1847123212/Zynq7010_eink_controller/controller/Eink_controller_V1.0/Eink_controller_V1.0.ip_user_files/sim_scripts/FRAME_LOGIC/activehdl/file_info.txt

axi4stream_vip_axi4streampc.sv,systemverilog,xilinx_vip,../../../../../../../../../Xilinx/Vivado/2020.2/data/xilinx_vip/hdl/axi4stream_vip_axi4streampc.sv,incdir="../../../../Eink_controller.gen/sources_1/ip/FRAME_LOGIC/hdl/verilog"
axi_vip_axi4pc.sv,systemverilog,xilinx_vip,../../../../../../../../../Xilinx/Vivado/2020.2/data/xilinx_vip/hdl/axi_vip_axi4pc.sv,incdir="../../../../Eink_controller.gen/sources_1/ip/FRAME_LOGIC/hdl/verilog"
xil_common_vip_pkg.sv,systemverilog,xilinx_vip,../../../../../../../../../Xilinx/Vivado/2020.2/data/xilinx_vip/hdl/xil_common_vip_pkg.sv,incdir="../../../../Eink_controller.gen/sources_1/ip/FRAME_LOGIC/hdl/verilog"
axi4stream_vip_pkg.sv,systemverilog,xilinx_vip,../../../../../../../../../Xilinx/Vivado/2020.2/data/xilinx_vip/hdl/axi4stream_vip_pkg.sv,incdir="../../../../Eink_controller.gen/sources_1/ip/FRAME_LOGIC/hdl/verilog"
axi_vip_pkg.sv,systemverilog,xilinx_vip,../../../../../../../../../Xilinx/Vivado/2020.2/data/xilinx_vip/hdl/axi_vip_pkg.sv,incdir="../../../../Eink_controller.gen/sources_1/ip/FRAME_LOGIC/hdl/verilog"
axi4stream_vip_if.sv,systemverilog,xilinx_vip,../../../../../../../../../Xilinx/Vivado/2020.2/data/xilinx_vip/hdl/axi4stream_vip_if.sv,incdir="../../../../Eink_controller.gen/sources_1/ip/FRAME_LOGIC/hdl/verilog"
axi_vip_if.sv,systemverilog,xilinx_vip,../../../../../../../../../Xilinx/Vivado/2020.2/data/xilinx_vip/hdl/axi_vip_if.sv,incdir="../../../../Eink_controller.gen/sources_1/ip/FRAME_LOGIC/hdl/verilog"
clk_vip_if.sv,systemverilog,xilinx_vip,../../../../../../../../../Xilinx/Vivado/2020.2/data/xilinx_vip/hdl/clk_vip_if.sv,incdir="../../../../Eink_controller.gen/sources_1/ip/FRAME_LOGIC/hdl/verilog"
rst_vip_if.sv,systemverilog,xilinx_vip,../../../../../../../../../Xilinx/Vivado/2020.2/data/xilinx_vip/hdl/rst_vip_if.sv,incdir="../../../../Eink_controller.gen/sources_1/ip/FRAME_LOGIC/hdl/verilog"
xpm_cdc.sv,systemverilog,xpm,../../../../../../../../../Xilinx/Vivado/2020.2/data/ip/xpm/xpm_cdc/hdl/xpm_cdc.sv,incdir="../../../../Eink_controller.gen/sources_1/ip/FRAME_LOGIC/hdl/verilog"
xpm_memory.sv,systemverilog,xpm,../../../../../../../../../Xilinx/Vivado/2020.2/data/ip/xpm/xpm_memory/hdl/xpm_memory.sv,incdir="../../../../Eink_controller.gen/sources_1/ip/FRAME_LOGIC/hdl/verilog"
xpm_fifo.sv,systemverilog,xpm,../../../../../../../../../Xilinx/Vivado/2020.2/data/ip/xpm/xpm_fifo/hdl/xpm_fifo.sv,incdir="../../../../Eink_controller.gen/sources_1/ip/FRAME_LOGIC/hdl/verilog"
xpm_VCOMP.vhd,vhdl,xpm,../../../../../../../../../Xilinx/Vivado/2020.2/data/ip/xpm/xpm_VCOMP.vhd,incdir="../../../../Eink_controller.gen/sources_1/ip/FRAME_LOGIC/hdl/verilog"
FRAME_LOGIC.v,verilog,xil_defaultlib,../../../../Eink_controller.gen/sources_1/ip/FRAME_LOGIC/sim/FRAME_LOGIC.v,incdir="../../../../Eink_controller.gen/sources_1/ip/FRAME_LOGIC/hdl/verilog"
glbl.v,Verilog,xil_defaultlib,glbl.v
