1847123212/Zynq7010_eink_controller/ALGO/Blue_Noise_Dithering/T1024_L1.5_2208x1872/texture.png

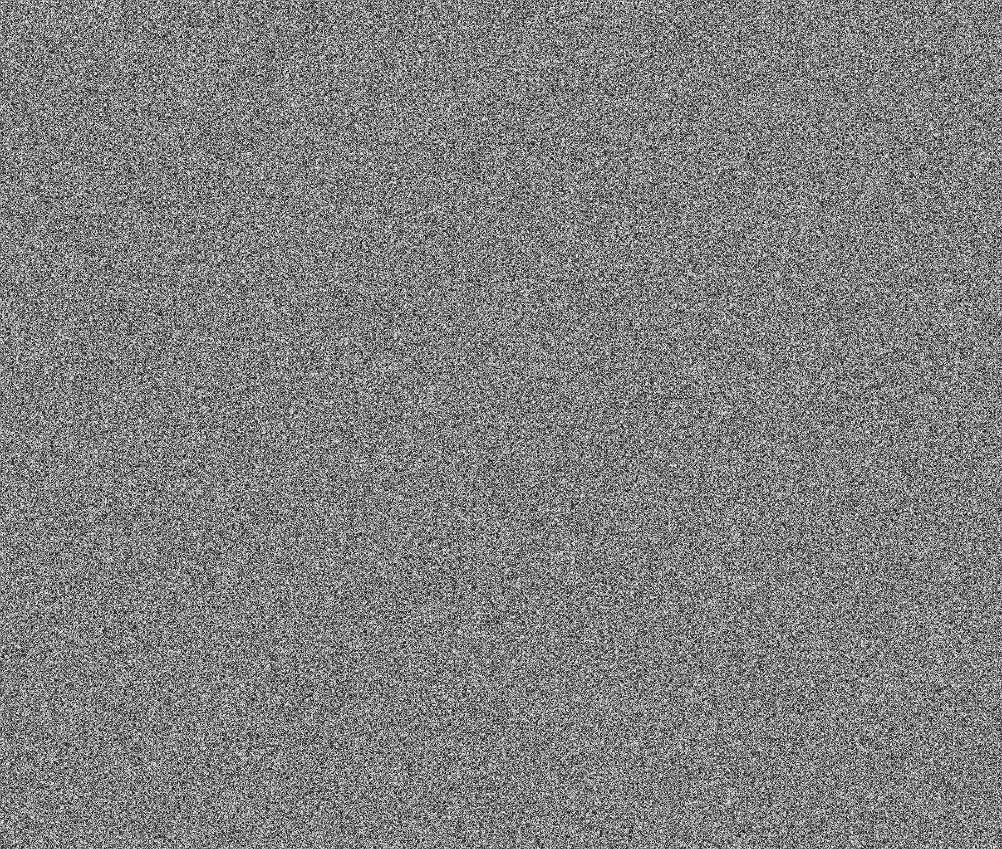
ALGO/Blue_Noise_Dithering/T1024_L1.5_2208x1872/texture.png
