1847123212/Zynq7010_eink_controller/controller/Eink_controller_V1.0/core/outRGB/matlab/image.png

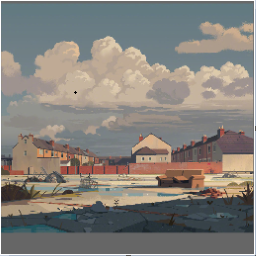
controller/Eink_controller_V1.0/core/outRGB/matlab/image.png
