1847123212/Zynq7010_eink_controller/controller/Eink_controller_V1.0/core/vivado-library/hls_contrast_stretch_1_0/hls_src/rover.bmp

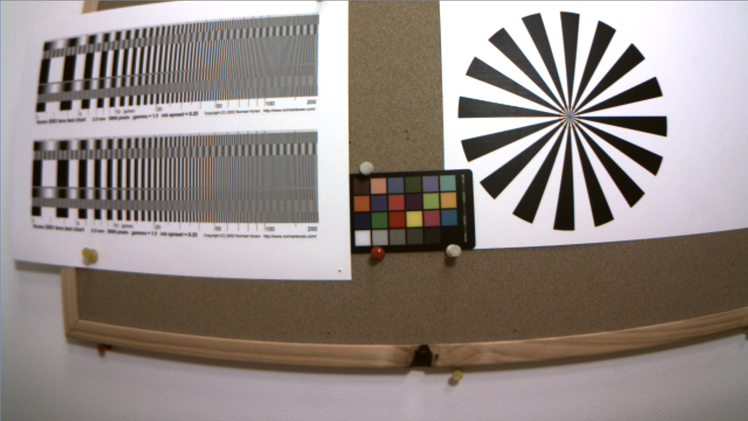
controller/Eink_controller_V1.0/core/vivado-library/hls_contrast_stretch_1_0/hls_src/rover.bmp
