1847123212/Zynq7010_eink_controller/controller/Eink_controller_V1.0/viewer/img_o/video/frame_8.png

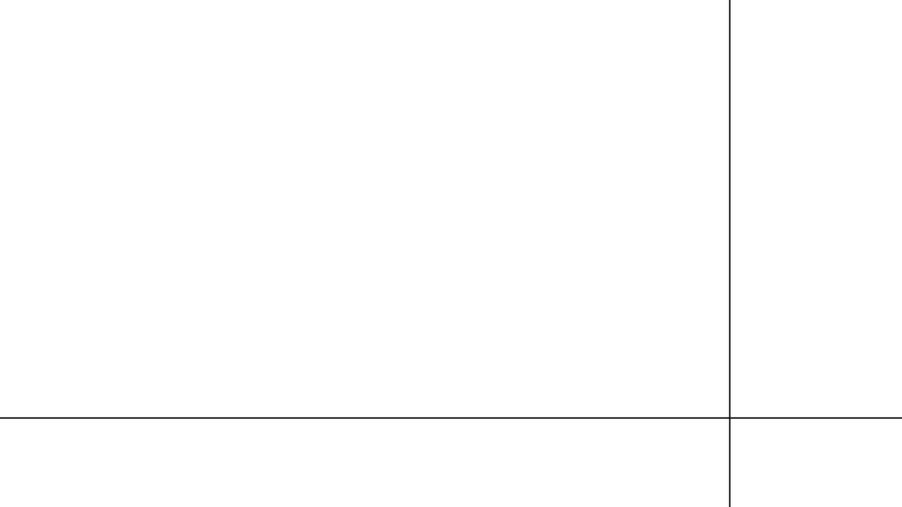
controller/Eink_controller_V1.0/viewer/img_o/video/frame_8.png
