1847123212/Zynq7010_eink_controller/log/20210805/20210804_IMG_1.JPG

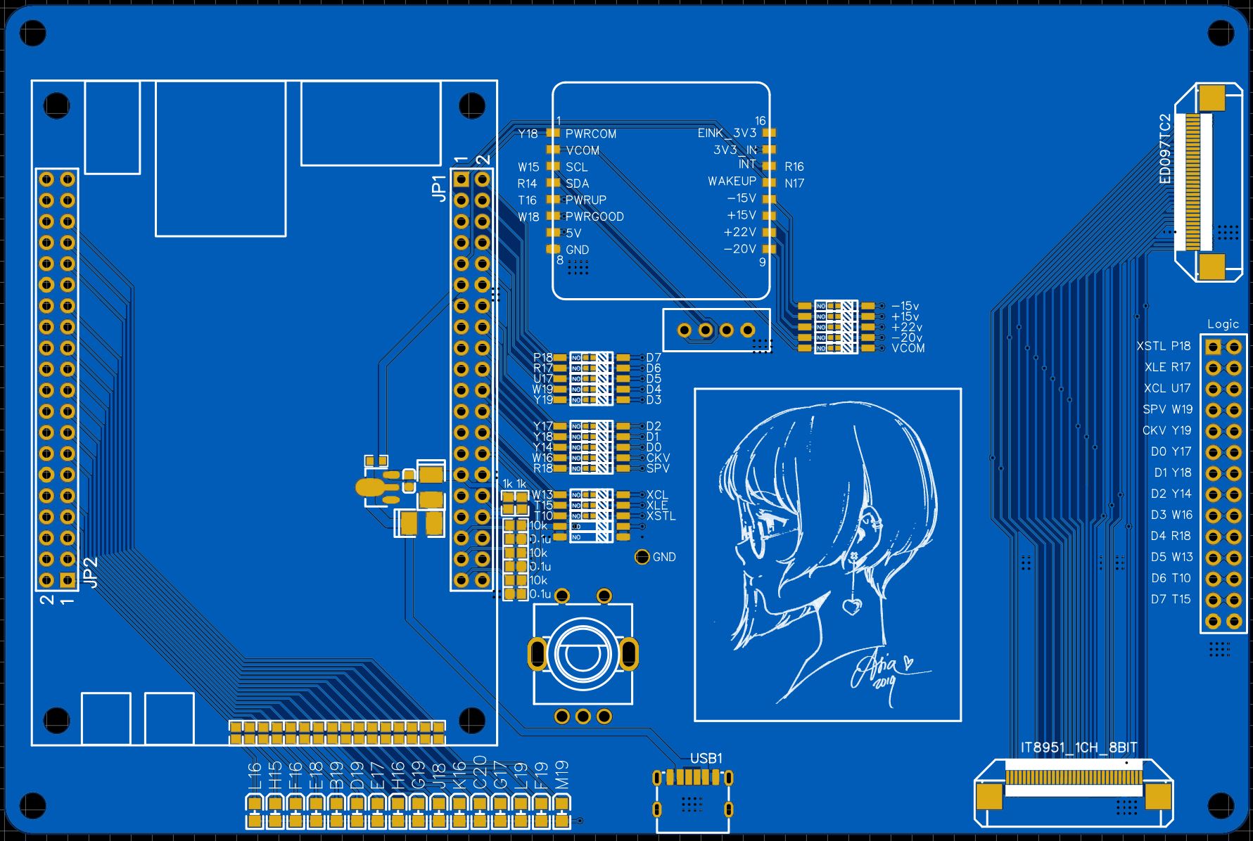
log/20210805/20210804_IMG_1.JPG
