1847123212/Zynq7010_eink_controller/log/20210810/20210809_IMG_2.JPG

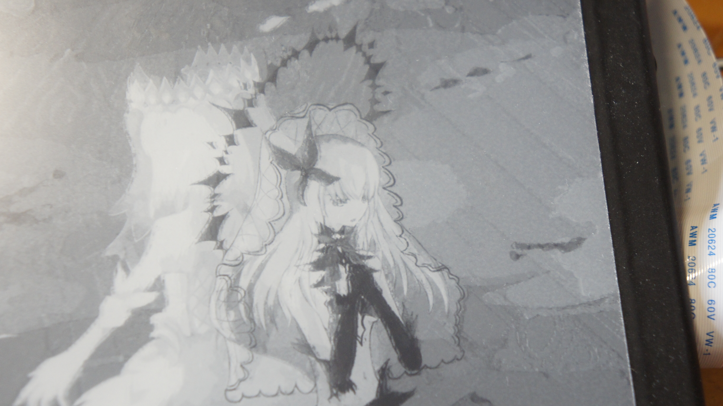
log/20210810/20210809_IMG_2.JPG
