1847123212/Zynq7010_eink_controller/log/20210822/20210822_IMG_1.JPG

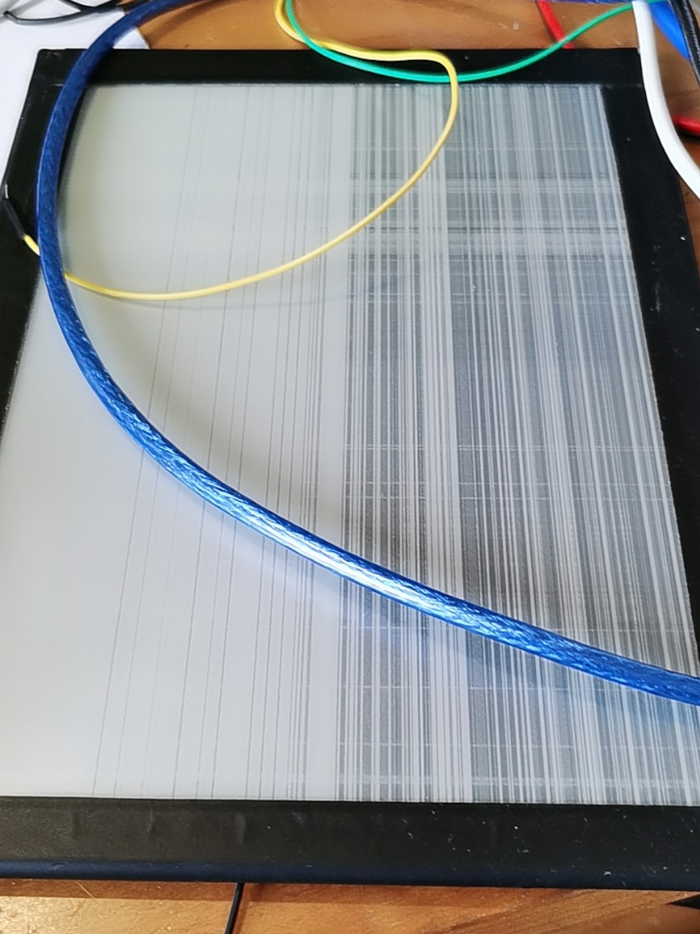
log/20210822/20210822_IMG_1.JPG
