1847123212/Zynq7010_eink_controller/log/20210909/20210909_IMG_2.JPG

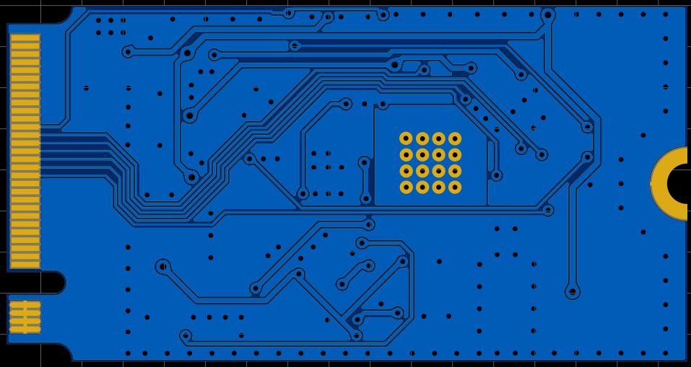
log/20210909/20210909_IMG_2.JPG
