1847123212/Zynq7010_eink_controller/log/20210911/20210911_IMG_1.JPG

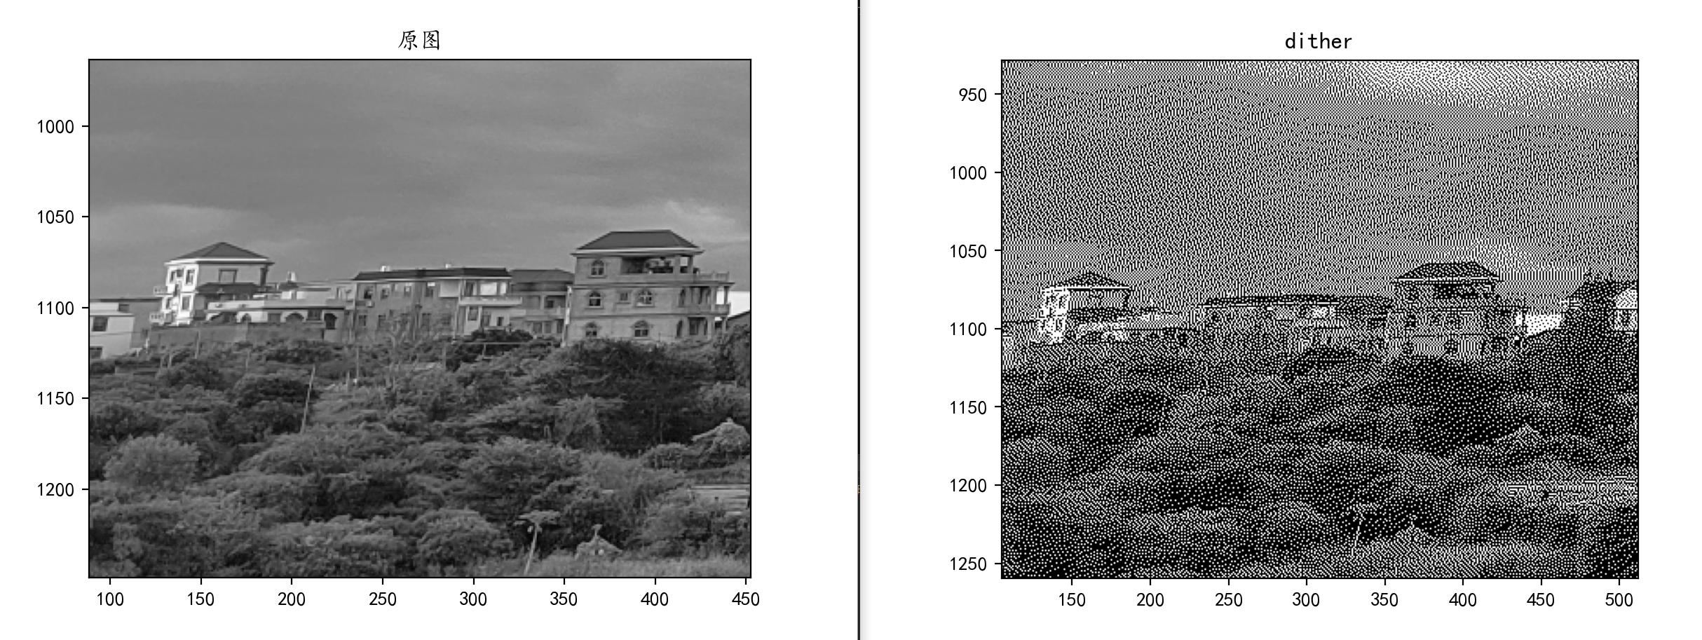
log/20210911/20210911_IMG_1.JPG
