1847123212/Zynq7010_eink_controller/log/20210913/20210913_IMG_1.JPG

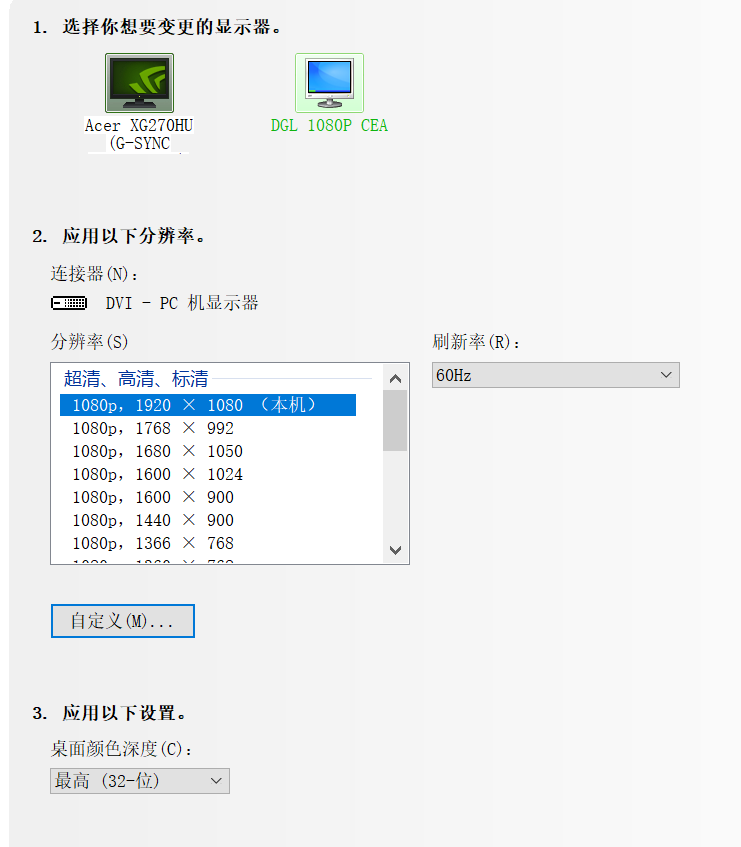
log/20210913/20210913_IMG_1.JPG
