1847123212/Zynq7010_eink_controller/log/20210915/20210915_IMG_2.JPG

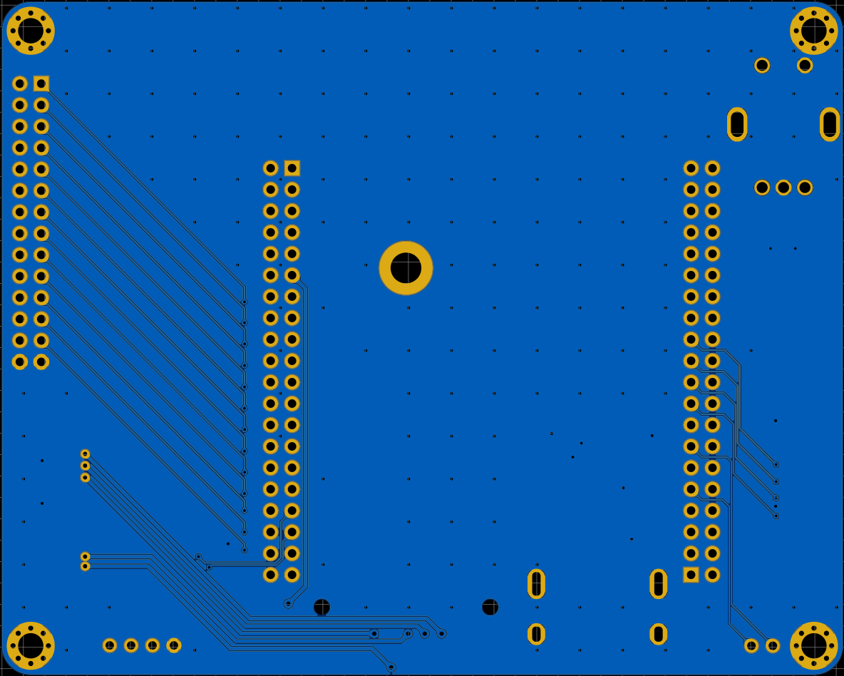
log/20210915/20210915_IMG_2.JPG
