1847123212/Zynq7010_eink_controller/log/20210917/20210917_IMG_7.JPG

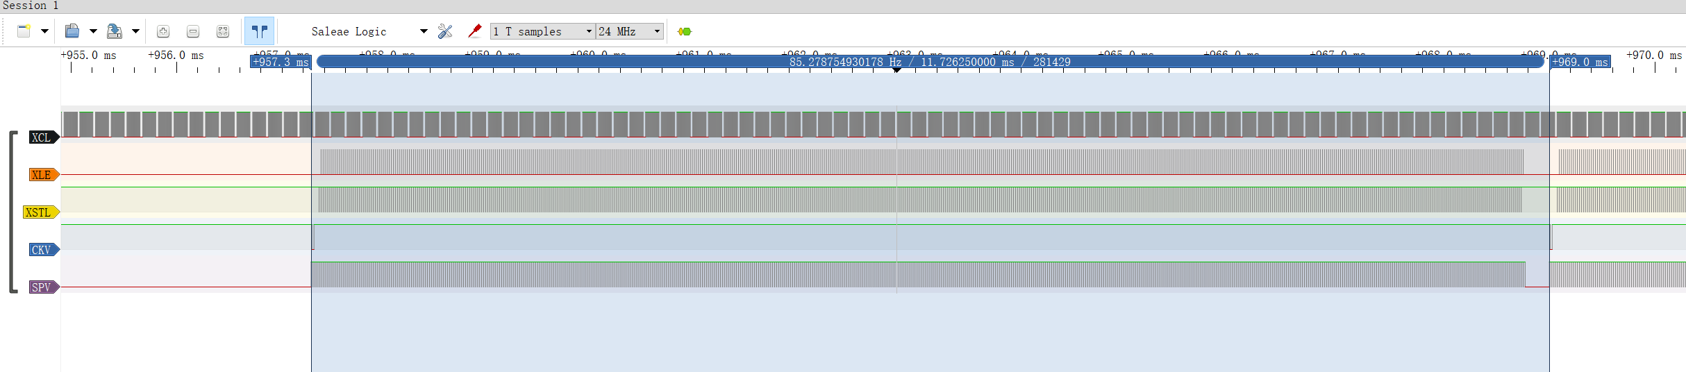
log/20210917/20210917_IMG_7.JPG
