1847123212/Zynq7010_eink_controller/log/20210930/20210930_IMG_2.JPG

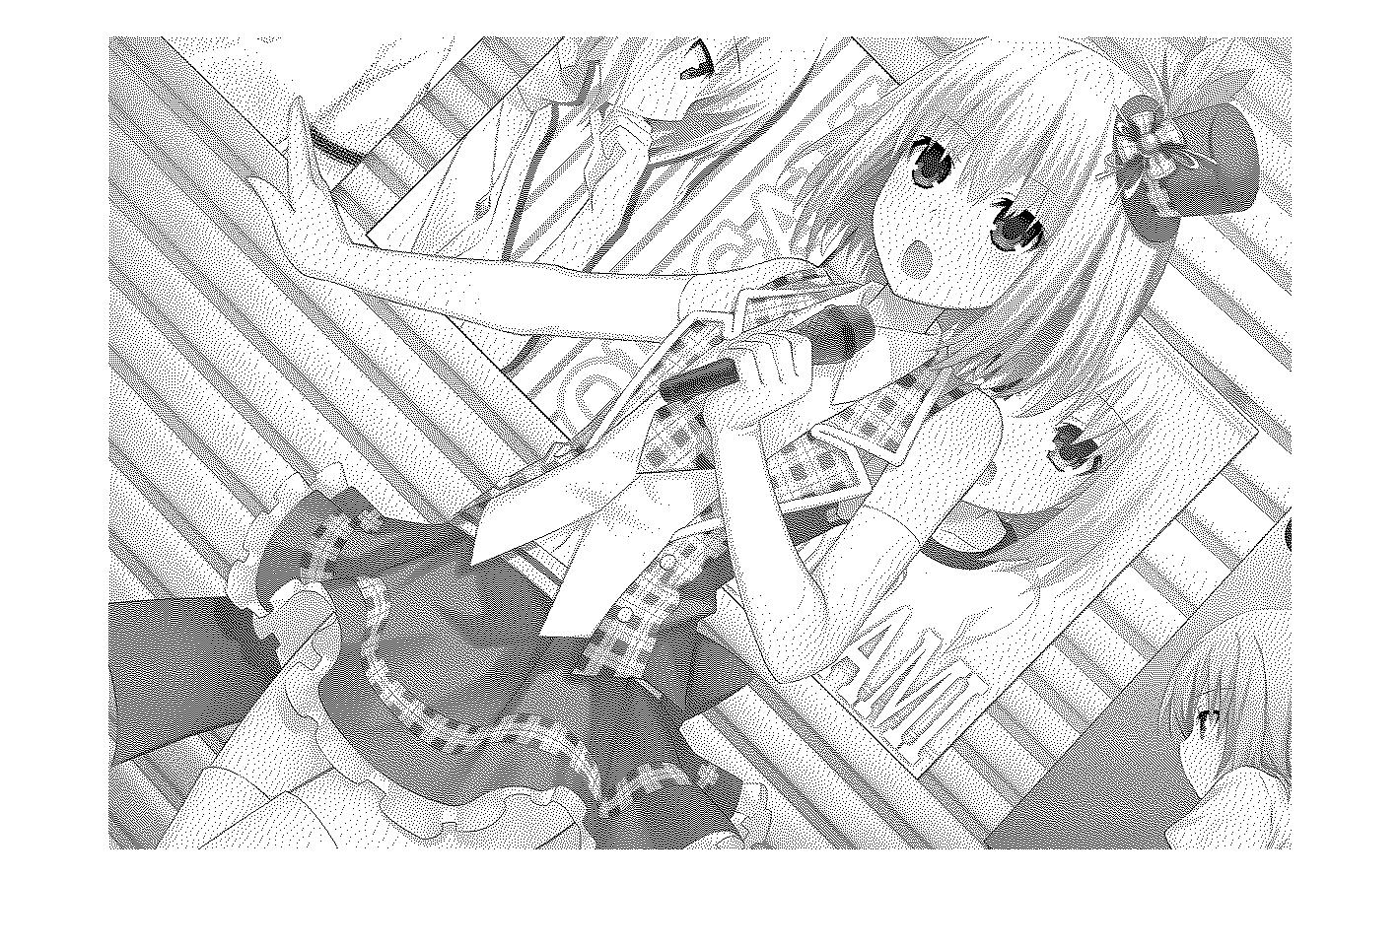
log/20210930/20210930_IMG_2.JPG
