1847123212/Zynq7010_eink_controller/log/20211019/20211019_IMG_1.JPG

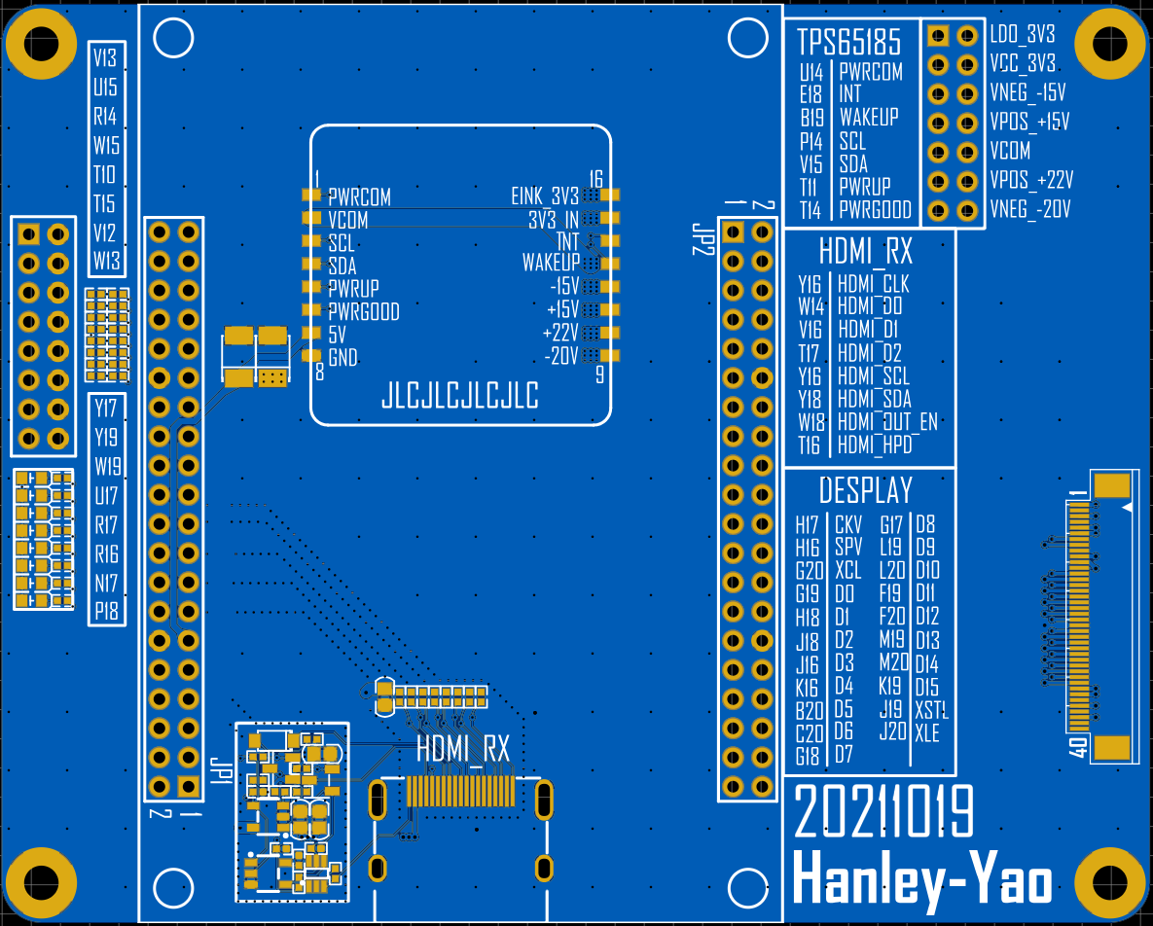
log/20211019/20211019_IMG_1.JPG
