1847123212/Zynq7010_eink_controller/log/20211031/20211031_IMG_1.JPG

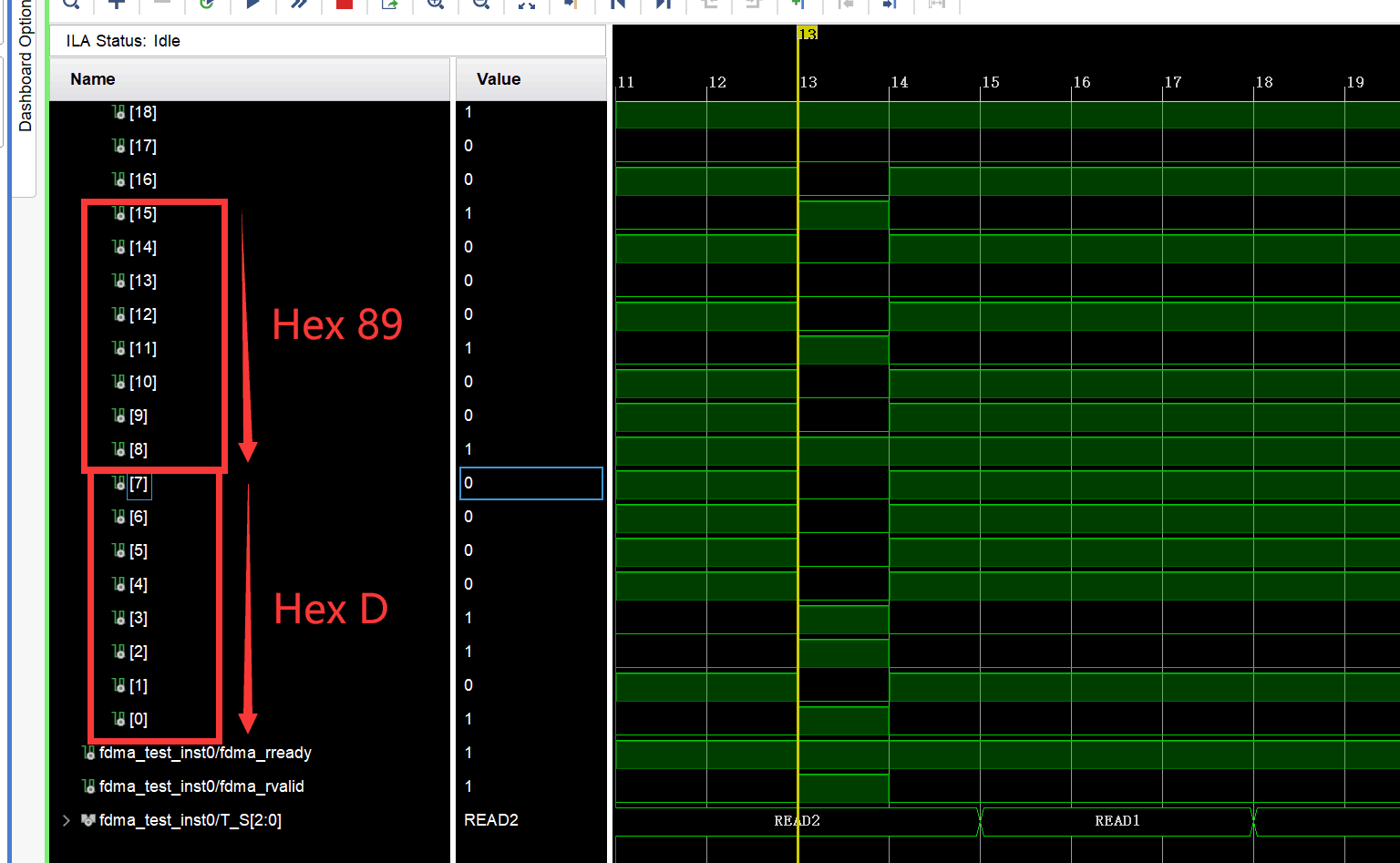
log/20211031/20211031_IMG_1.JPG
