1847123212/Zynq7010_eink_controller/log/20211107/20211107_IMG_2.JPG

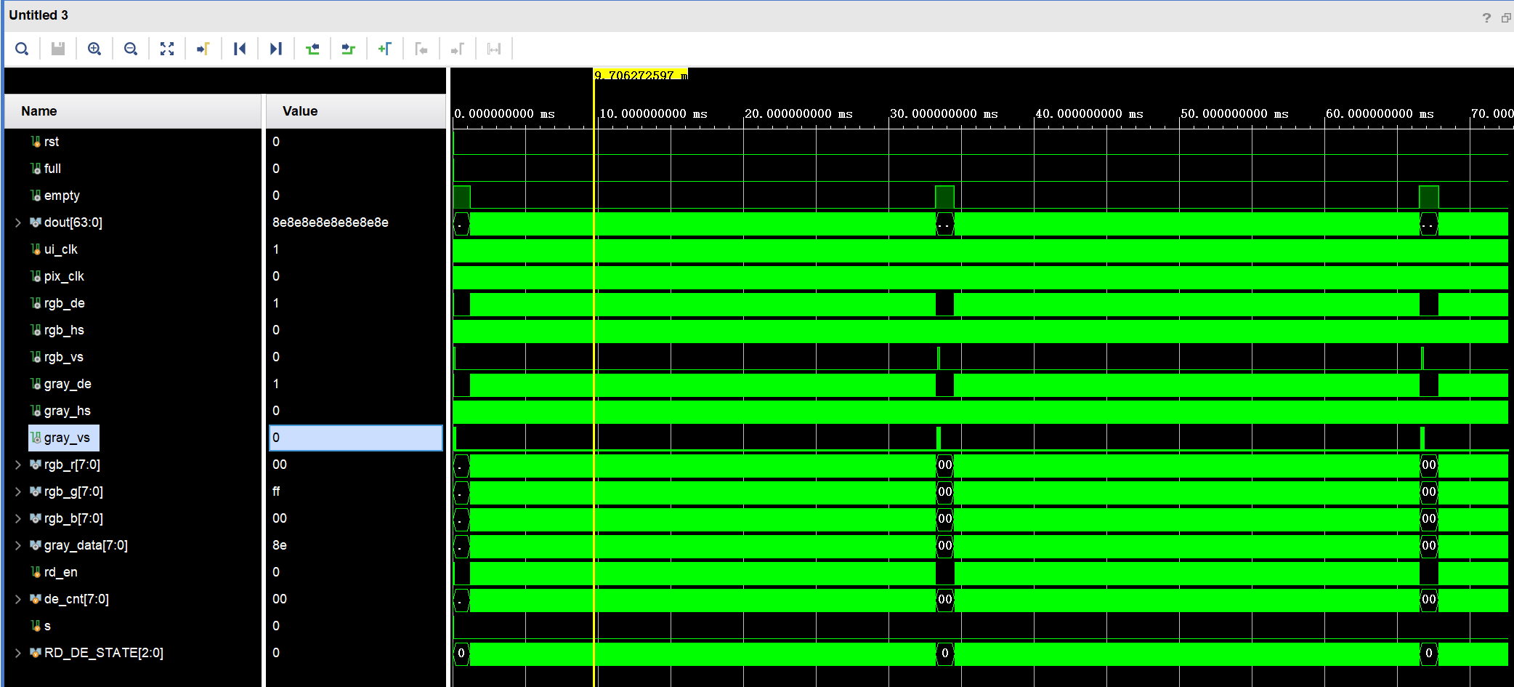
log/20211107/20211107_IMG_2.JPG
