1847123212/Zynq7010_eink_controller/log/20211114/20211114_IMG_2.JPG

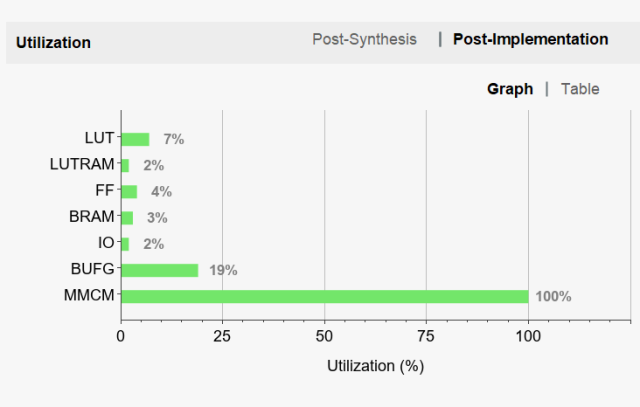
log/20211114/20211114_IMG_2.JPG
