1847123212/Zynq7010_eink_controller/log/20211123/20211123_IMG_2.JPG

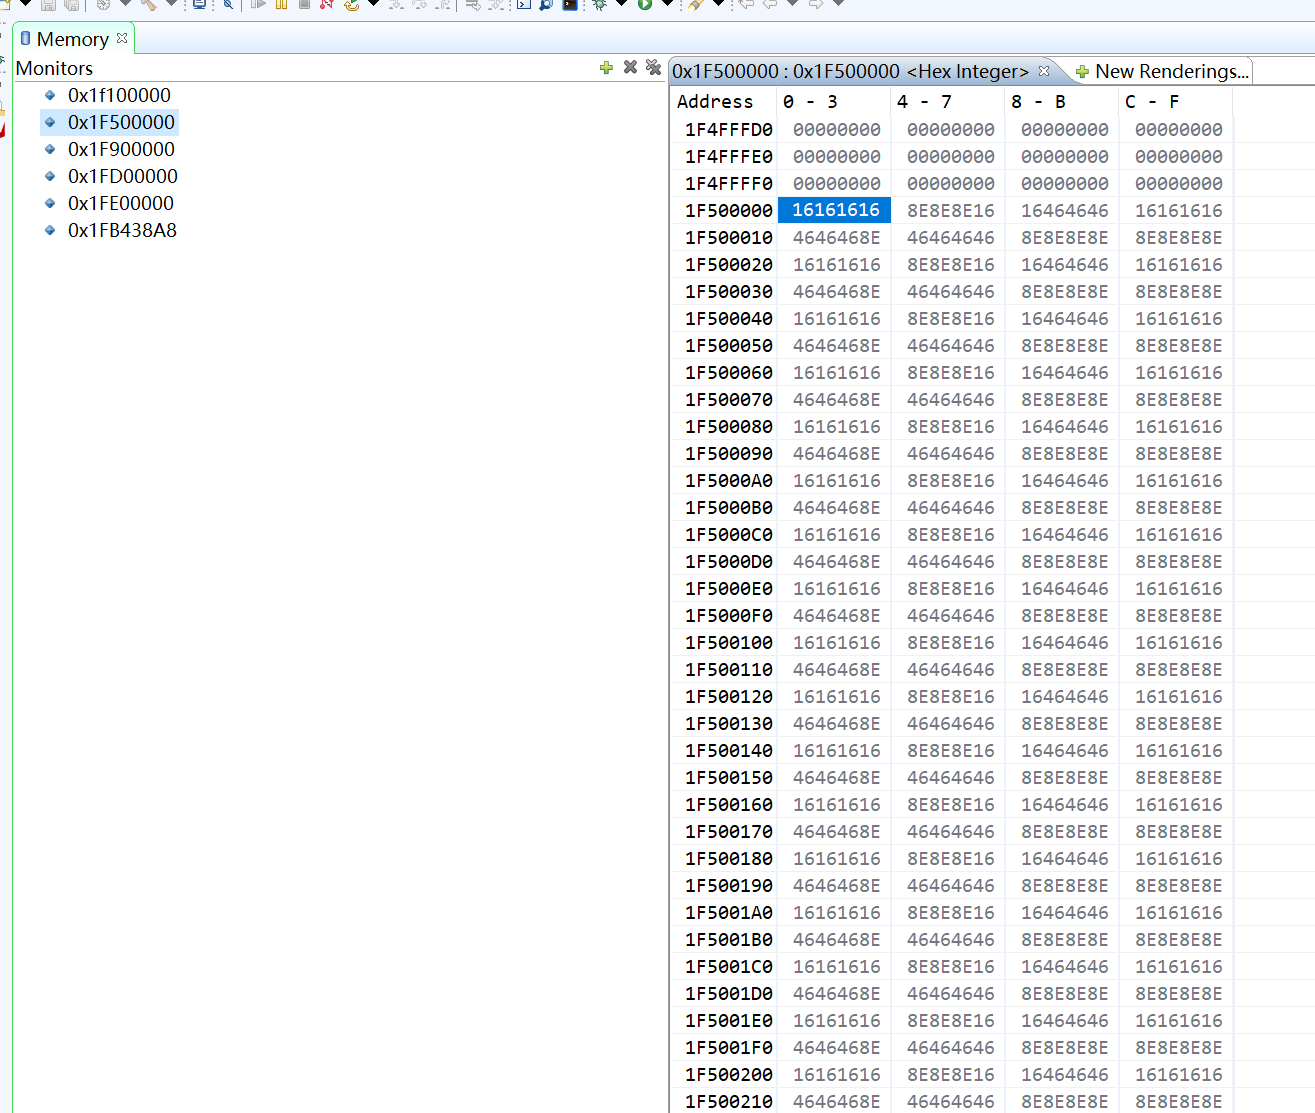
log/20211123/20211123_IMG_2.JPG
