1847123212/Zynq7010_eink_controller/log/20211212/20211212_IMG_2.JPG

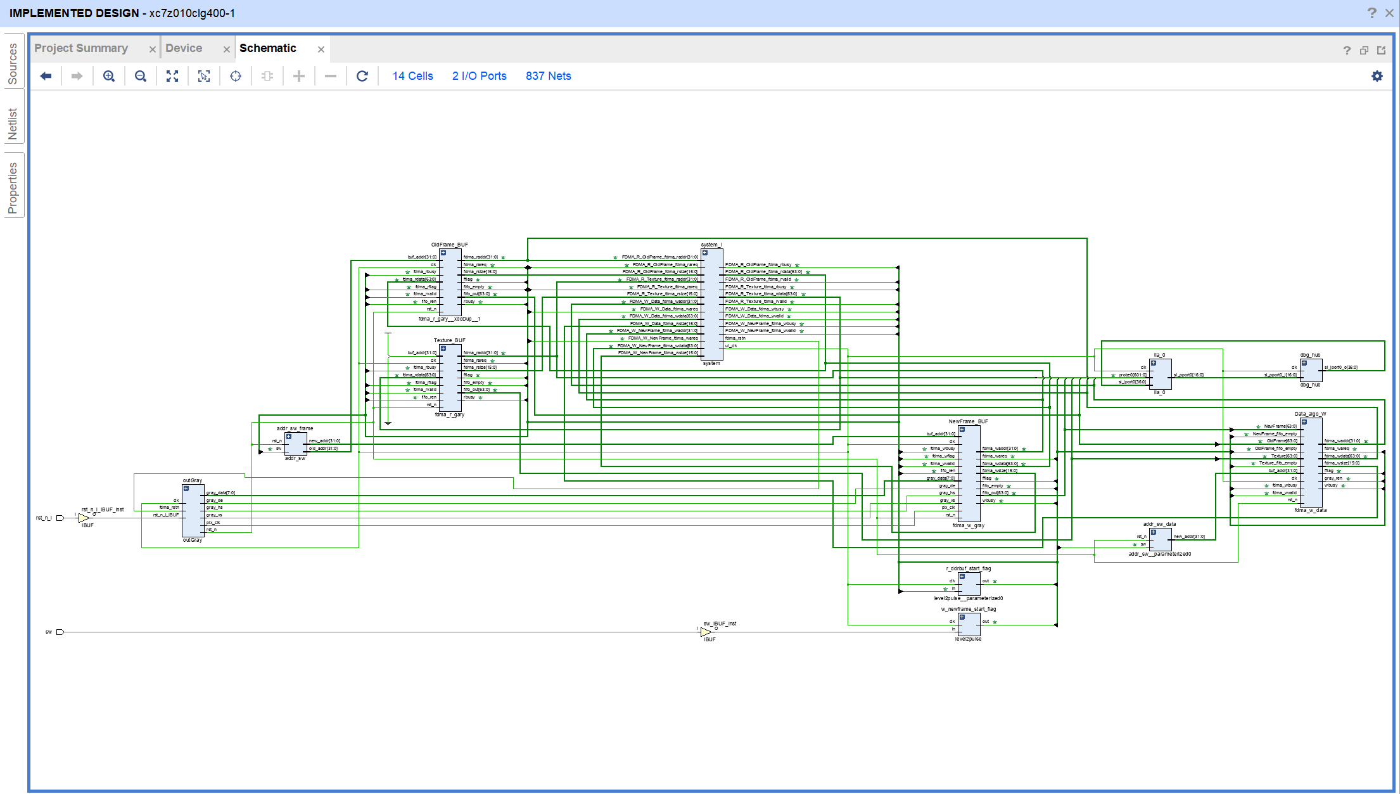
log/20211212/20211212_IMG_2.JPG
