1847123212/Zynq7010_eink_controller/log/20211220/20211220_IMG_1.JPG

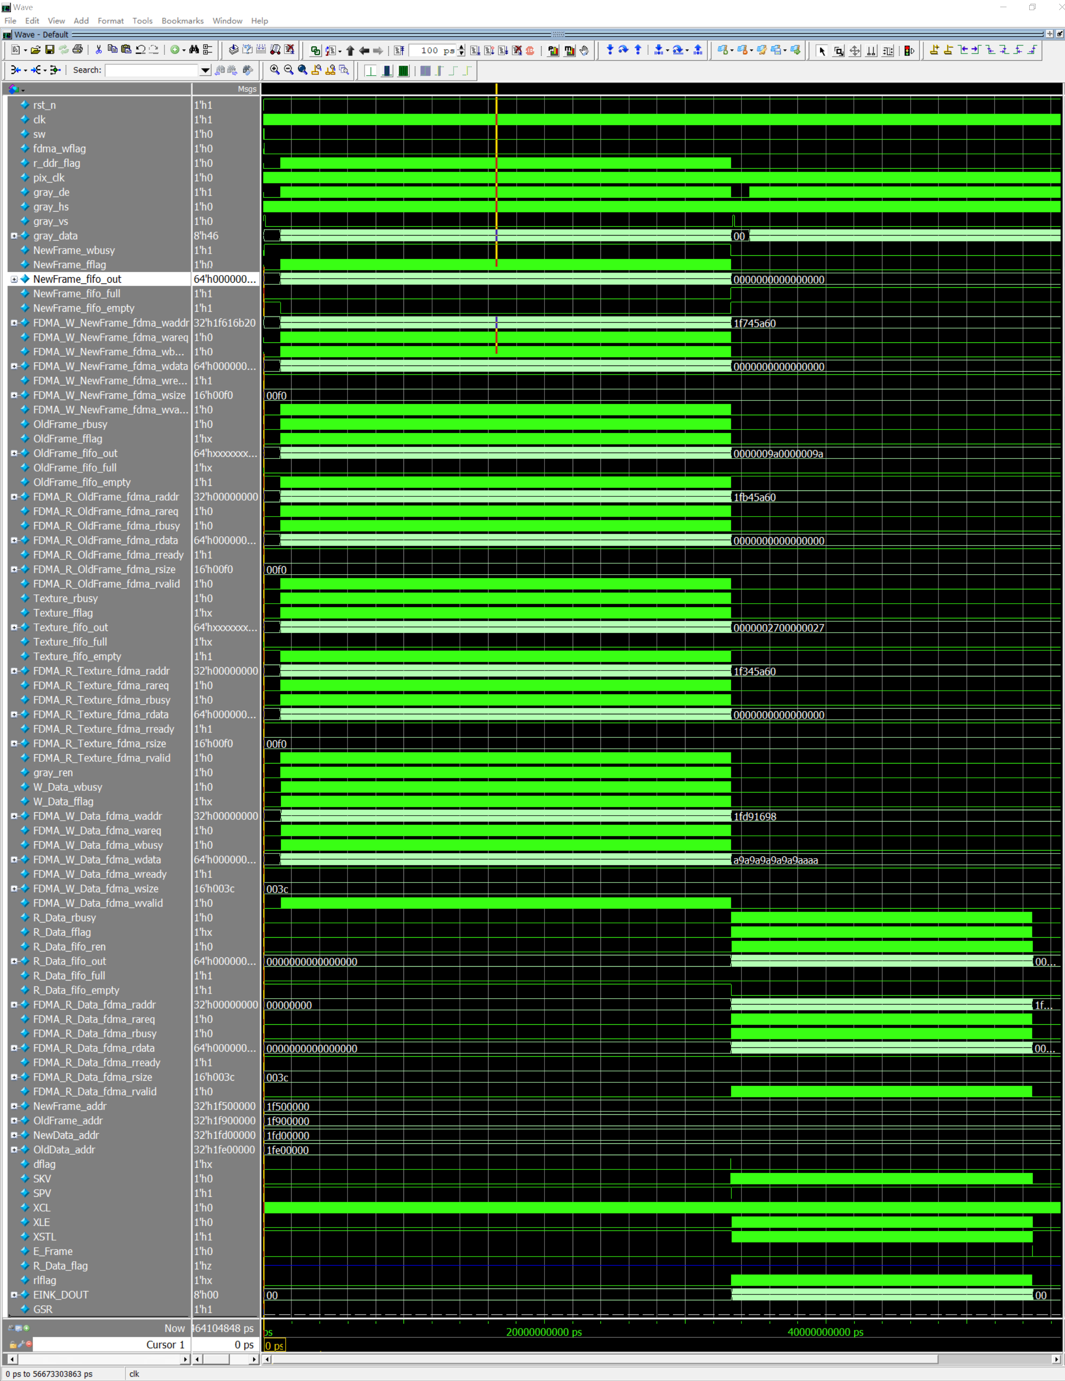
log/20211220/20211220_IMG_1.JPG
