1847123212/Zynq7010_eink_controller/log/20220624/20220624_IMG_2.JPG

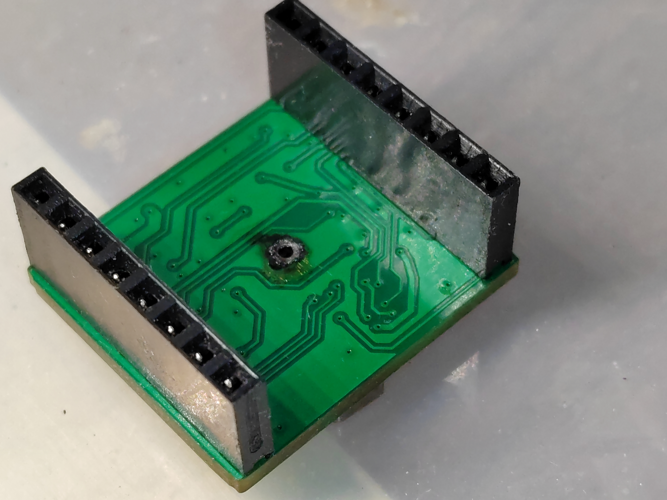
log/20220624/20220624_IMG_2.JPG
