1847123212/Zynq7010_eink_controller/log/20220816/20220816_IMG_3.JPG

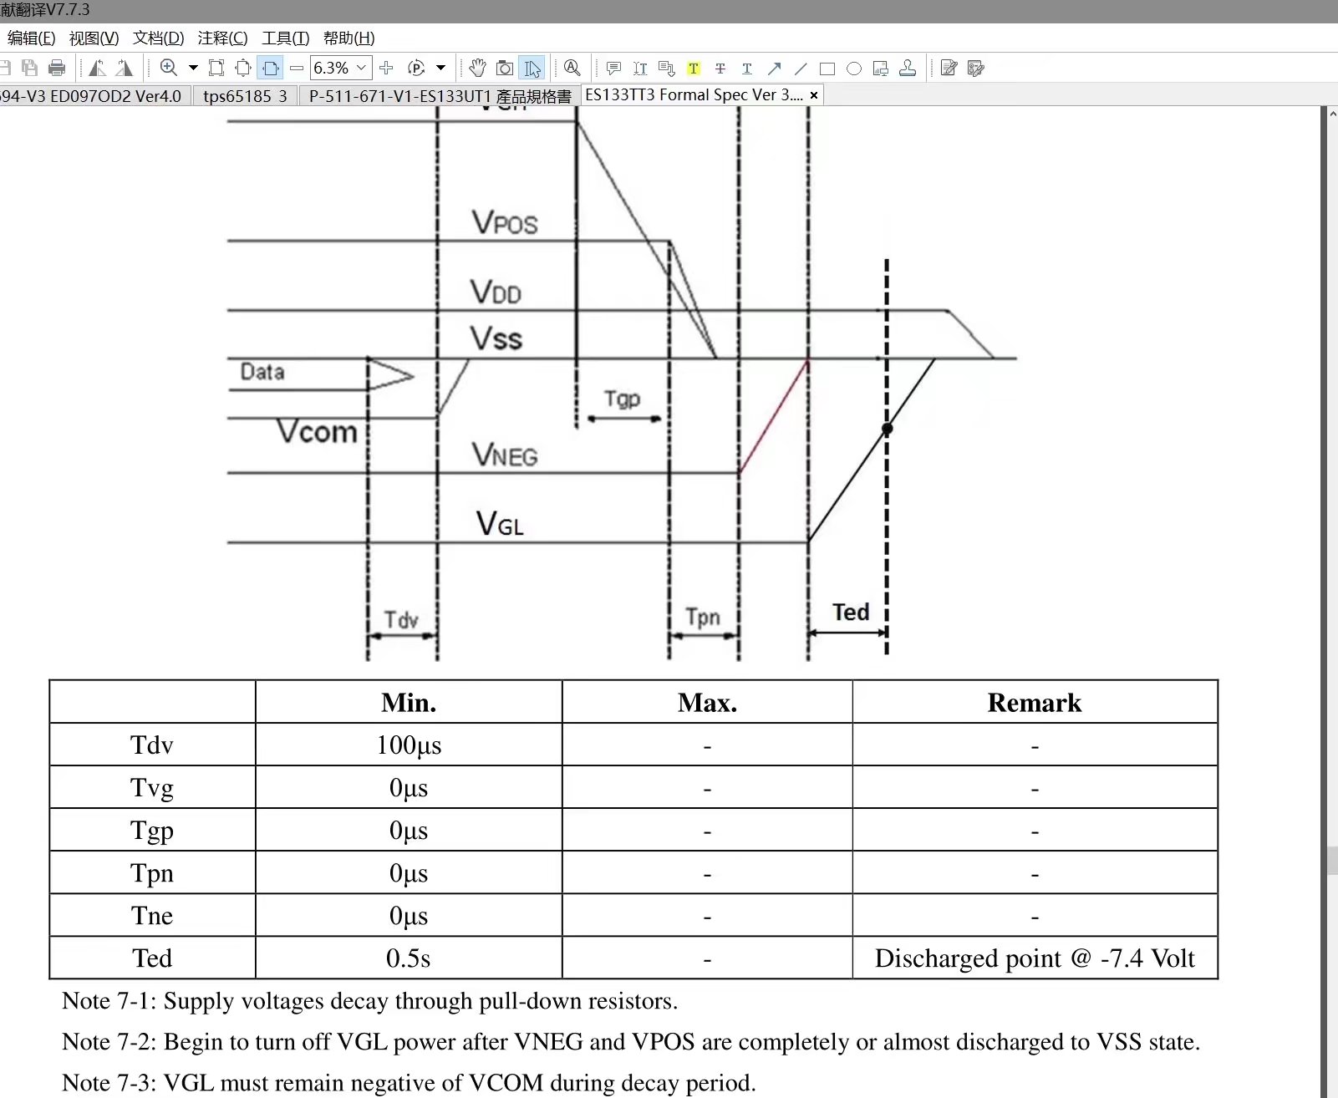
log/20220816/20220816_IMG_3.JPG
