1847123212/Zynq7010_eink_controller/log/20220818/20220818_IMG_1.JPG

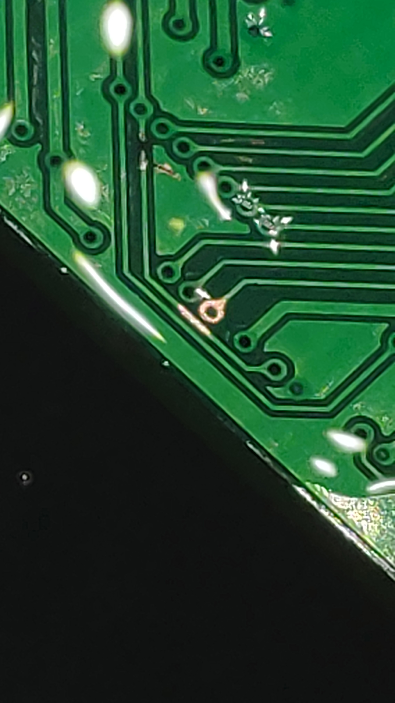
log/20220818/20220818_IMG_1.JPG
