1847123212/Zynq7010_eink_controller/ALGO/Algo_test/7/误差扩散结果.bmp

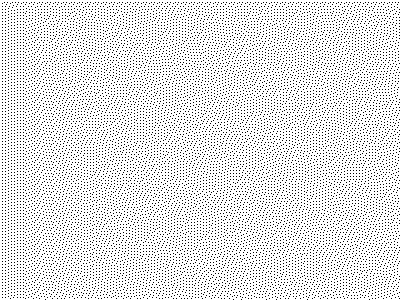
ALGO/Algo_test/7/误差扩散结果.bmp
