1847123212/Zynq7010_eink_controller/ALGO/Algo_test/16/蓝噪声结果.bmp

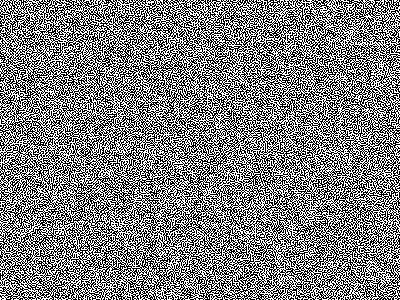
ALGO/Algo_test/16/蓝噪声结果.bmp
