1847123212/Zynq7010_eink_controller/ALGO/Algo_test/18/原图.bmp

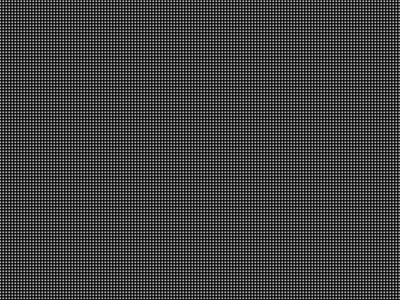
ALGO/Algo_test/18/原图.bmp
