1847123212/Zynq7010_eink_controller/ALGO/Algo_test/18/蓝噪声结果.bmp

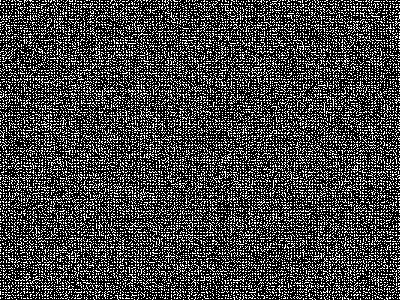
ALGO/Algo_test/18/蓝噪声结果.bmp
