1847123212/Zynq7010_eink_controller/ALGO/Algo_test/27/误差扩散傅里叶变换结果.bmp

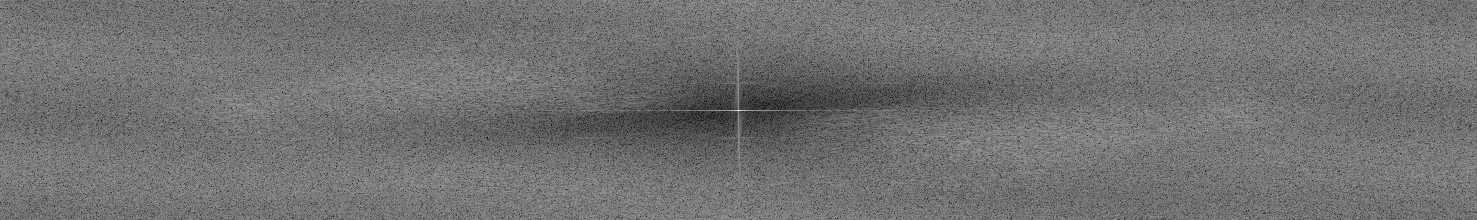
ALGO/Algo_test/27/误差扩散傅里叶变换结果.bmp
