1847123212/Zynq7010_eink_controller/controller/Eink_controller_V1.0/core/vivado-library/video_scaler/hls_src/test/fox.bmp

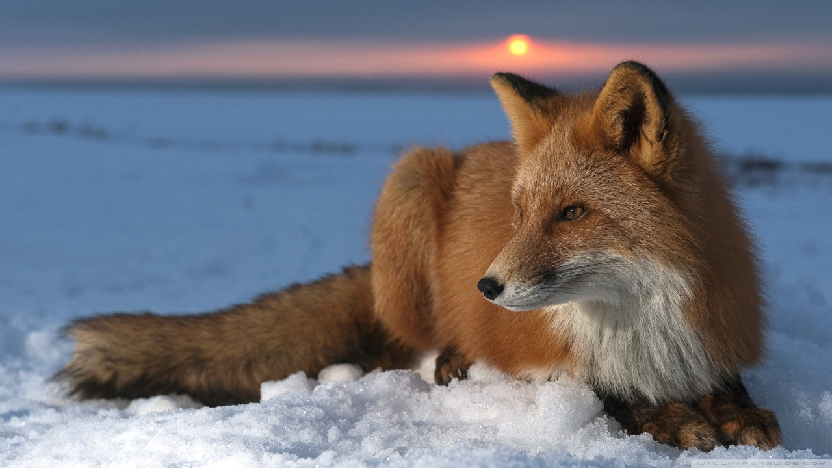
controller/Eink_controller_V1.0/core/vivado-library/video_scaler/hls_src/test/fox.bmp
