1847123212/Zynq7010_eink_controller/(list of files, drawings)

Other design files:
hardware/TPS65185/TPS65185.PrjPcb
hardware/TPS65185/TPS65185.SchDoc
hardware/Z7_Lite/Z7_Lite.PcbDoc
hardware/Z7_Lite/Z7_Lite.PrjPcb
hardware/Z7_Lite/Z7_Lite.SchDoc
