1847123212/Zynq7010_eink_controller/controller/Eink_controller_V1.0/Eink_controller_V1.0.ip_user_files/ip/DATA_MGR_LOGIC/DATA_MGR_LOGIC_stub.v

// Copyright 1986-2020 Xilinx, Inc. All Rights Reserved.
// --------------------------------------------------------------------------------
// Tool Version: Vivado v.2020.2 (win64) Build 3064766 Wed Nov 18 09:12:45 MST 2020
// Date        : Sat May 21 16:17:24 2022
// Host        : Duller running 64-bit major release  (build 9200)
// Command     : write_verilog -force -mode synth_stub
//               c:/Users/Admin/Desktop/Zynq7010_eink_controller/controller/Eink_controller_V1.0/Eink_controller_V1.0.gen/sources_1/ip/DATA_MGR_LOGIC/DATA_MGR_LOGIC_stub.v
// Design      : DATA_MGR_LOGIC
// Purpose     : Stub declaration of top-level module interface
// Device      : xc7z010clg400-1
// --------------------------------------------------------------------------------

// This empty module with port declaration file causes synthesis tools to infer a black box for IP.
// The synthesis directives are for Synopsys Synplify support to prevent IO buffer insertion.
// Please paste the declaration into a Verilog source file or add the file as an additional source.
(* X_CORE_INFO = "ila,Vivado 2020.2" *)
module DATA_MGR_LOGIC(clk, probe0)
/* synthesis syn_black_box black_box_pad_pin="clk,probe0[83:0]" */;
  input clk;
  input [83:0]probe0;
endmodule
