1847123212/Zynq7010_eink_controller/controller/Eink_controller_V1.0/Eink_controller_V1.0.ip_user_files/ip/DATA_MGR_LOGIC/DATA_MGR_LOGIC_stub.vhdl

-- Copyright 1986-2020 Xilinx, Inc. All Rights Reserved.
-- --------------------------------------------------------------------------------
-- Tool Version: Vivado v.2020.2 (win64) Build 3064766 Wed Nov 18 09:12:45 MST 2020
-- Date        : Sat May 21 16:17:24 2022
-- Host        : Duller running 64-bit major release  (build 9200)
-- Command     : write_vhdl -force -mode synth_stub
--               c:/Users/Admin/Desktop/Zynq7010_eink_controller/controller/Eink_controller_V1.0/Eink_controller_V1.0.gen/sources_1/ip/DATA_MGR_LOGIC/DATA_MGR_LOGIC_stub.vhdl
-- Design      : DATA_MGR_LOGIC
-- Purpose     : Stub declaration of top-level module interface
-- Device      : xc7z010clg400-1
-- --------------------------------------------------------------------------------
library IEEE;
use IEEE.STD_LOGIC_1164.ALL;

entity DATA_MGR_LOGIC is
  Port ( 
    clk : in STD_LOGIC;
    probe0 : in STD_LOGIC_VECTOR ( 83 downto 0 )
  );

end DATA_MGR_LOGIC;

architecture stub of DATA_MGR_LOGIC is
attribute syn_black_box : boolean;
attribute black_box_pad_pin : string;
attribute syn_black_box of stub : architecture is true;
attribute black_box_pad_pin of stub : architecture is "clk,probe0[83:0]";
attribute X_CORE_INFO : string;
attribute X_CORE_INFO of stub : architecture is "ila,Vivado 2020.2";
begin
end;
