1847123212/Zynq7010_eink_controller/controller/Eink_controller_V1.0/Eink_controller_V1.0.ip_user_files/ip/rgb2dvi_0/rgb2dvi_0_stub.vhdl

-- Copyright 1986-2020 Xilinx, Inc. All Rights Reserved.
-- --------------------------------------------------------------------------------
-- Tool Version: Vivado v.2020.2 (win64) Build 3064766 Wed Nov 18 09:12:45 MST 2020
-- Date        : Sun Mar 13 14:07:52 2022
-- Host        : Duller running 64-bit major release  (build 9200)
-- Command     : write_vhdl -force -mode synth_stub
--               c:/Users/Admin/Desktop/Zynq7010_eink_controller/controller/Eink_controller/Eink_controller.gen/sources_1/ip/rgb2dvi_0/rgb2dvi_0_stub.vhdl
-- Design      : rgb2dvi_0
-- Purpose     : Stub declaration of top-level module interface
-- Device      : xc7z010clg400-1
-- --------------------------------------------------------------------------------
library IEEE;
use IEEE.STD_LOGIC_1164.ALL;

entity rgb2dvi_0 is
  Port ( 
    TMDS_Clk_p : out STD_LOGIC;
    TMDS_Clk_n : out STD_LOGIC;
    TMDS_Data_p : out STD_LOGIC_VECTOR ( 2 downto 0 );
    TMDS_Data_n : out STD_LOGIC_VECTOR ( 2 downto 0 );
    aRst_n : in STD_LOGIC;
    vid_pData : in STD_LOGIC_VECTOR ( 23 downto 0 );
    vid_pVDE : in STD_LOGIC;
    vid_pHSync : in STD_LOGIC;
    vid_pVSync : in STD_LOGIC;
    PixelClk : in STD_LOGIC
  );

end rgb2dvi_0;

architecture stub of rgb2dvi_0 is
attribute syn_black_box : boolean;
attribute black_box_pad_pin : string;
attribute syn_black_box of stub : architecture is true;
attribute black_box_pad_pin of stub : architecture is "TMDS_Clk_p,TMDS_Clk_n,TMDS_Data_p[2:0],TMDS_Data_n[2:0],aRst_n,vid_pData[23:0],vid_pVDE,vid_pHSync,vid_pVSync,PixelClk";
attribute x_core_info : string;
attribute x_core_info of stub : architecture is "rgb2dvi,Vivado 2020.2";
begin
end;
