1847123212/Zynq7010_eink_controller/controller/Eink_controller_V1.0/Eink_controller_V1.0.srcs/sources_1/new/xpm_fifo_wgray_buf.v

//////////////////////////////////////////////////////////////////////////////////
//
//  INST_XPM_FIFO_ASYNC
//
//////////////////////////////////////////////////////////////////////////////////

module xpm_fifo_wgray_buf #(
    parameter FDMA_WID = 64,  // FDMA数据宽度
    parameter FRAME_H  = 1920
    )
    (
    input wire                  rst_n,
    input wire                  wr_clk,
    input wire                  rd_clk,
    input wire  [7:0]           din,
    input wire                  wr_en,
    input wire                  rd_en,
    output wire [FDMA_WID -1:0] dout,
    output wire                 full,
    output wire                 empty
    );

    function integer depth (
        input integer width,  // 接口位宽
        input integer length,  // 数据长度
        input integer bpp      // 像素位数
        );
        for(depth=16; depth < ((length * bpp + width - 1) / width)*2; depth = depth*2) begin end  // 求最合适的写入深度
    endfunction

    localparam DEPTH = depth(8, FRAME_H, 8);  // 输入位宽8bit

    // xpm_fifo_async: Synchronous FIFO
    // Xilinx Parameterized Macro, version 2020.2

    xpm_fifo_async #(
            .CDC_SYNC_STAGES(2),
            .DOUT_RESET_VALUE("0"),
            .ECC_MODE("no_ecc"),
            .FIFO_MEMORY_TYPE("block"),
            .FIFO_READ_LATENCY(0),
            .FIFO_WRITE_DEPTH(DEPTH),
            .FULL_RESET_VALUE(0),
            .PROG_EMPTY_THRESH(10),
            .PROG_FULL_THRESH(10),
            .RD_DATA_COUNT_WIDTH(1),
            .READ_DATA_WIDTH(FDMA_WID),
            .READ_MODE("fwft"),
            .RELATED_CLOCKS(0),
            .SIM_ASSERT_CHK(0),
            .USE_ADV_FEATURES("0000"),
            .WAKEUP_TIME(0),
            .WRITE_DATA_WIDTH(8),
            .WR_DATA_COUNT_WIDTH(1)
        ) xpm_fifo_async (
            .almost_empty(),
            .almost_full(),
            .data_valid(),
            .dbiterr(),
            .dout(dout),
            .empty(empty),
            .full(full),
            .overflow(),
            .prog_empty(),
            .prog_full(),
            .rd_data_count(),
            .rd_rst_busy(),
            .sbiterr(),
            .underflow(),
            .wr_ack(),
            .wr_data_count(),
            .wr_rst_busy(),
            .din(din),
            .injectdbiterr(1'b0),
            .injectsbiterr(1'b0),
            .rd_clk(rd_clk),
            .rd_en(rd_en),
            .rst(~rst_n),
            .sleep(1'b0),
            .wr_clk(wr_clk),
            .wr_en(wr_en)
        );

endmodule
