1847123212/Zynq7010_eink_controller/controller/Eink_controller_V1.0/core/outRGB/outRGB.srcs/sources_1/new/outRGB.v

`timescale 1ns / 1ps
//////////////////////////////////////////////////////////////////////////////////
// Company:
// Engineer:
//
// Create Date: 2021/10/31 19:09:54
// Design Name:
// Module Name: outRGB
// Project Name:
// Target Devices:
// Tool Versions:
// Description:
//
// Dependencies:
//
// Revision:
// Revision 0.01 - File Created
// Additional Comments:
//
//////////////////////////////////////////////////////////////////////////////////


module outRGB(
    input wire clk,
    input wire rst_n,
    input wire IMAGE_EN,
    input wire [23:0] PURE_COLOR,
    output wire pix_clk,
    output wire rgb_de,
    output wire rgb_hs,
    output wire rgb_vs,
    output wire [7:0] rgb_r,
    output wire [7:0] rgb_g,
    output wire [7:0] rgb_b
    );

    wire rst;
    wire locked;

    assign rst = ~locked;

    clk_wiz_0 clock(
            // Clock out ports
            .clk_out1(pix_clk), // output clk_out1
            // Status and control signals
            .resetn(rst_n),     // input resetn
            .locked(locked),     // output locked
            // Clock in ports
            .clk_in1(clk)    // input clk_in1
        );

    wire [23:0] rd_data;
    wire [23:0] img;
    wire        rd_ren;

    assign rd_req = rd_ren && IMAGE_EN;

    assign img = IMAGE_EN ? rd_data : PURE_COLOR;  // PURE_COLOR = 24'h7F7F7F

    rd_image inst_rd_image (
            .clk     (pix_clk),
            .rst     (rst),
            .rd_req  (rd_req),
            .rd_data (rd_data)
        );

    vga_shift inst_vga_shift (
            .rst      (rst),
            .vpg_pclk (pix_clk),
            .rd_data  (img),
            .rd_req   (rd_ren),
            .vpg_de   (rgb_de),
            .vpg_hs   (rgb_hs),
            .vpg_vs   (rgb_vs),
            .rgb_r    (rgb_r),
            .rgb_g    (rgb_g),
            .rgb_b    (rgb_b)
        );

endmodule
