1847123212/Zynq7010_eink_controller/controller/Eink_controller_V1.0/Eink_controller_V1.0.srcs/sim_1/new/iic_config_tb.v

`timescale 1ns / 1ps

module iic_config_tb();

    reg     clk;
    reg     rst_n;
    wire    scl;
    wire    sda;
    wire    cfg_done;

    initial begin
        clk = 0;
        forever #(10) clk = ~clk;  // 50Mhz
    end

    initial begin
        rst_n = 0;
        repeat(100) @(posedge clk);
        rst_n = 1;
    end

    iic_config #(
            .VCOM(2780),
            .SYS_CLK_FREQ(50),
            .SCL_FREQ(100)
        ) inst_iic_config (
            .clk      (clk),
            .rst_n    (rst_n),
            .scl      (scl),
            .sda      (sda),
            .cfg_done (cfg_done)
        );

    EEPROM_AT24C64_SIM EEPROM_AT24C64_SIM (.scl(scl), .sda(sda));  // 用于写入测试

endmodule
