1847123212/Zynq7010_eink_controller/(commit log)

2021-09-19 commit message
    [PmodDHB1_MotorFeedback_0_0.xml, constrs.xlsx]
2021-09-19 七夕特别篇
2021-10-20 修正线宽
2021-11-28 Final image processing √
2022-03-10 V1.0
    202203112434发布正式版9.7寸Eink控制器
    [TPS65185.PrjPcb, TPS65185.SchDoc, Z7_Lite.PcbDoc, Z7_Lite.PrjPcb, Z7_Lite.SchDoc, constrs.xlsx, system_top_tb_time_synth.sdf]
2022-03-21 Update README.md
    警告
2022-07-10 支持EBAZ4205/Z7-Lite
    [PmodDHB1_MotorFeedback_0_0.xml, rgb2gray_tb_time_synth.sdf]
